cherry-embedded/HSLink-hardware/HSLinkIso_v1.2.2/HSLinkIso_v1.2.2.pdf

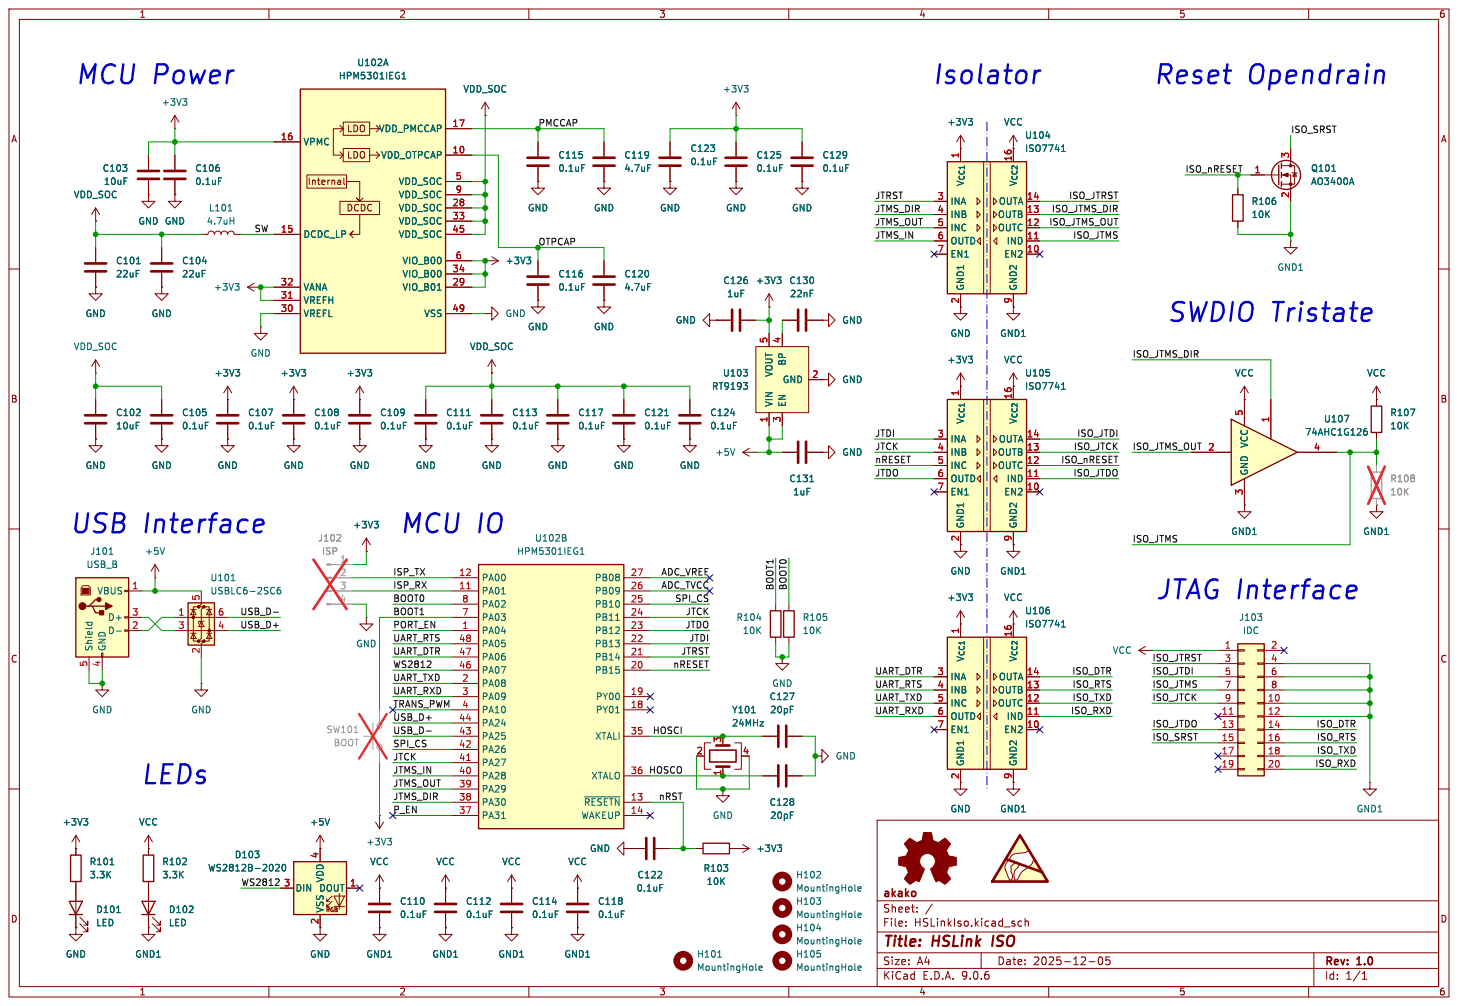
[picture p1: page 1]

File: HSLinkIso.kicad_sch Sheet: / akako

Id: 1/1 Title: HSLink ISO
