cherry-embedded/HSLink-hardware/HSLinkIso_v1.2.2/HSLinkIso.kicad_pcb

## KiCad design HSLinkIso_v1.2.2/HSLinkIso.kicad_pcb (2025-12-05)

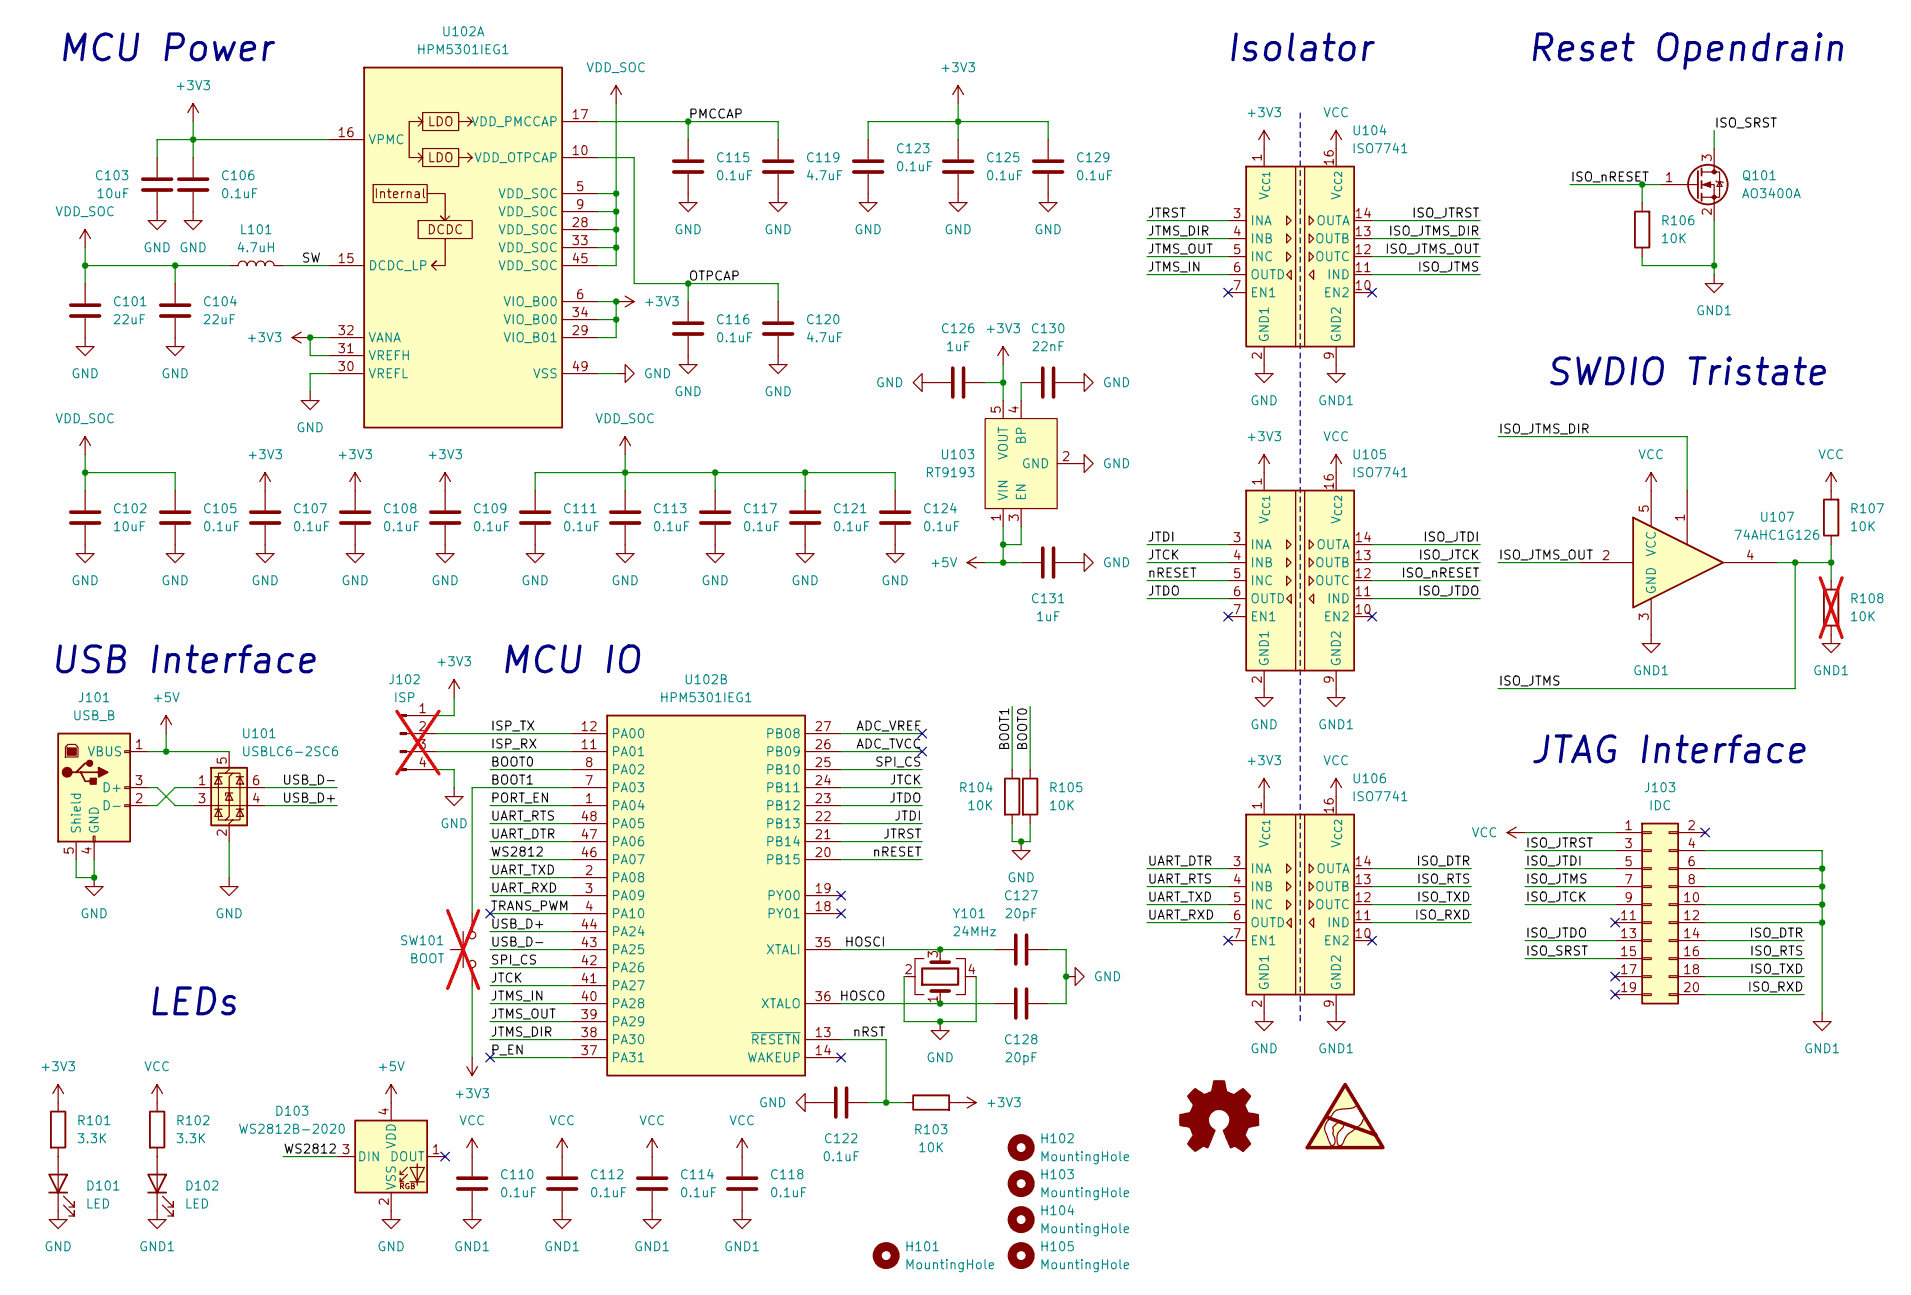
[picture p2: schematic HSLinkIso.kicad_sch, HSLink ISO]

Parts:
C101, C104: 22uF; C_0805_2012Metric
C102, C103: 10uF; C_0805_2012Metric
C105, C106, C107, C108, C109, C110, C111, C112, C113, C114, C115, C116, C117, C118, C121, C122, C123, C124, C125, C129: 0.1uF; C_0603_1608Metric
C119, C120: 4.7uF; C_0603_1608Metric
C126, C131: 1uF; C_0603_1608Metric
C127, C128: 20pF; C_0603_1608Metric
C130: 22nF; C_0603_1608Metric
D101, D102: LED; LED_0603_1608Metric
D103: WS2812B-2020; LED_WS2812B-2020_PLCC4_2.0x2.0mm
H101: MountingHole; MountingHole_3.2mm_M3
H102, H103, H104, H105: MountingHole; MountingHole_2.2mm_M2
J101: USB_B; USB_B_Lumberg_2411_02_Horizontal
J102: ISP; PinHeader_1x04_P2.54mm_Vertical; not fitted
J103: IDC; IDC-Header_2x10_P2.54mm_Horizontal
L101: 4.7uH; L_Sunlord_SWPA4020S
Q101: AO3400A; SOT-23
R101, R102: 3.3K; R_0603_1608Metric
R103, R104, R105, R106, R107: 10K; R_0603_1608Metric
R108: 10K; R_0603_1608Metric; not fitted
SW101: BOOT; PinHeader_1x02_P2.54mm_Vertical; not fitted
U101: USBLC6-2SC6; SOT-23-6
U102: HPM5301IEG1; QFN-48-1EP_6x6mm_P0.4mm_EP4.2x4.2mm
U103: RT9193; SOT-23-5
U104, U105, U106: ISO7741; QSOP-16_3.9x4.9mm_P0.635mm
U107: 74AHC1G126; SOT-23-5
Y101: 24MHz; Crystal_SMD_3225-4Pin_3.2x2.5mm

Connections:
+3V3: C103.1, C106.1, C107.1, C108.1, C109.1, C123.1, C125.1, C126.1, C129.1, J102.1, R101.1, R103.2, SW101.2, U102.6 (VIO_B00), U102.16 (VPMC), U102.29 (VIO_B01), U102.31 (VREFH), U102.32 (VANA), U102.34 (VIO_B00), U103.5 (VOUT), U104.1 (V_{CC1}), U105.1 (V_{CC1}), U106.1 (V_{CC1})
+5V: C131.1, D103.4 (VDD), J101.1 (VBUS), U101.5 (VBUS), U103.1 (VIN), U103.3 (EN)
/ADC_TVCC: U102.26 (PB09)
/ADC_VREF: U102.27 (PB08)
/BOOT0: R105.1, U102.8 (PA02)
/BOOT1: R104.1, SW101.1, U102.7 (PA03)
/HOSCI: C127.1, U102.35 (XTALI), Y101.3
/HOSCO: C128.1, U102.36 (XTALO), Y101.1
/ISO_DTR: J103.14, U106.14 (OUTA)
/ISO_JTCK: J103.9, U105.13 (OUTB)
/ISO_JTDI: J103.5, U105.14 (OUTA)
/ISO_JTDO: J103.13, U105.11 (IND)
/ISO_JTMS: J103.7, R107.1, R108.2, U104.11 (IND), U107.4
/ISO_JTMS_DIR: U104.13 (OUTB), U107.1
/ISO_JTMS_OUT: U104.12 (OUTC), U107.2
/ISO_JTRST: J103.3, U104.14 (OUTA)
/ISO_RTS: J103.16, U106.13 (OUTB)
/ISO_RXD: J103.20, U106.11 (IND)
/ISO_SRST: J103.15, Q101.3 (D)
/ISO_TXD: J103.18, U106.12 (OUTC)
/ISO_nRESET: Q101.1 (G), R106.2, U105.12 (OUTC)
/ISP_RX: J102.3, U102.11 (PA01)
/ISP_TX: J102.2, U102.12 (PA00)
/JTCK: U102.24 (PB11), U102.41 (PA27), U105.4 (INB)
/JTDI: U102.22 (PB13), U105.3 (INA)
/JTDO: U102.23 (PB12), U105.6 (OUTD)
/JTMS_DIR: U102.38 (PA30), U104.4 (INB)
/JTMS_IN: U102.40 (PA28), U104.6 (OUTD)
/JTMS_OUT: U102.39 (PA29), U104.5 (INC)
/JTRST: U102.21 (PB14), U104.3 (INA)
/OTPCAP: C116.1, C120.1, U102.10 (VDD_OTPCAP)
/PMCCAP: C115.1, C119.1, U102.17 (VDD_PMCCAP)
/PORT_EN: U102.1 (PA04)
/P_EN: U102.37 (PA31)
/SPI_CS: U102.25 (PB10), U102.42 (PA26)
/SW: L101.2, U102.15 (DCDC_LP)
/TRANS_PWM: U102.4 (PA10)
/UART_DTR: U102.47 (PA06), U106.3 (INA)
/UART_RTS: U102.48 (PA05), U106.4 (INB)
/UART_RXD: U102.3 (PA09), U106.6 (OUTD)
/UART_TXD: U102.2 (PA08), U106.5 (INC)
/USB_D+: U101.4 (I/O2), U102.44 (PA24)
/USB_D-: U101.6 (I/O1), U102.43 (PA25)
/WS2812: D103.3 (DIN), U102.46 (PA07)
/nRESET: U102.20 (PB15), U105.5 (INC)
/nRST: C122.1, R103.1, U102.13 (~RESETN)
GND: C101.2, C102.2, C103.2, C104.2, C105.2, C106.2, C107.2, C108.2, C109.2, C111.2, C113.2, C115.2, C116.2, C117.2, C119.2, C120.2, C121.2, C122.2, C123.2, C124.2, C125.2, C126.2, C127.2, C128.2, C129.2, C130.2, C131.2, D101.1 (K), D103.2 (VSS), J101.4 (GND), J101.5 (Shield), J102.4, R104.2, R105.2, U101.2 (GND), U102.30 (VREFL), U102.49 (VSS), U103.2 (GND), U104.2 (GND1), U104.8 (GND1), U105.2 (GND1), U105.8 (GND1), U106.2 (GND1), U106.8 (GND1), Y101.2, Y101.4
GND1: C110.2, C112.2, C114.2, C118.2, D102.1 (K), J103.4, J103.6, J103.8, J103.10, J103.12, Q101.2 (S), R106.1, R108.1, U104.9 (GND2), U104.15 (GND2), U105.9 (GND2), U105.15 (GND2), U106.9 (GND2), U106.15 (GND2), U107.3 (GND)
unnamed: D101.2 (A), R101.2
unnamed: D102.2 (A), R102.2
unnamed: J101.3 (D+), U101.3 (I/O2)
unnamed: J101.2 (D-), U101.1 (I/O1)
unnamed: C130.1, U103.4 (BP)
VCC: C110.1, C112.1, C114.1, C118.1, J103.1, R102.1, R107.2, U104.16 (V_{CC2}), U105.16 (V_{CC2}), U106.16 (V_{CC2}), U107.5 (VCC)
VDD_SOC: C101.1, C102.1, C104.1, C105.1, C111.1, C113.1, C117.1, C121.1, C124.1, L101.1, U102.5 (VDD_SOC), U102.9 (VDD_SOC), U102.28 (VDD_SOC), U102.33 (VDD_SOC), U102.45 (VDD_SOC)

Notes on the sheet:
JTAG Interface
Isolator
USB Interface
Reset Opendrain
MCU Power
MCU IO
SWDIO Tristate
LEDs

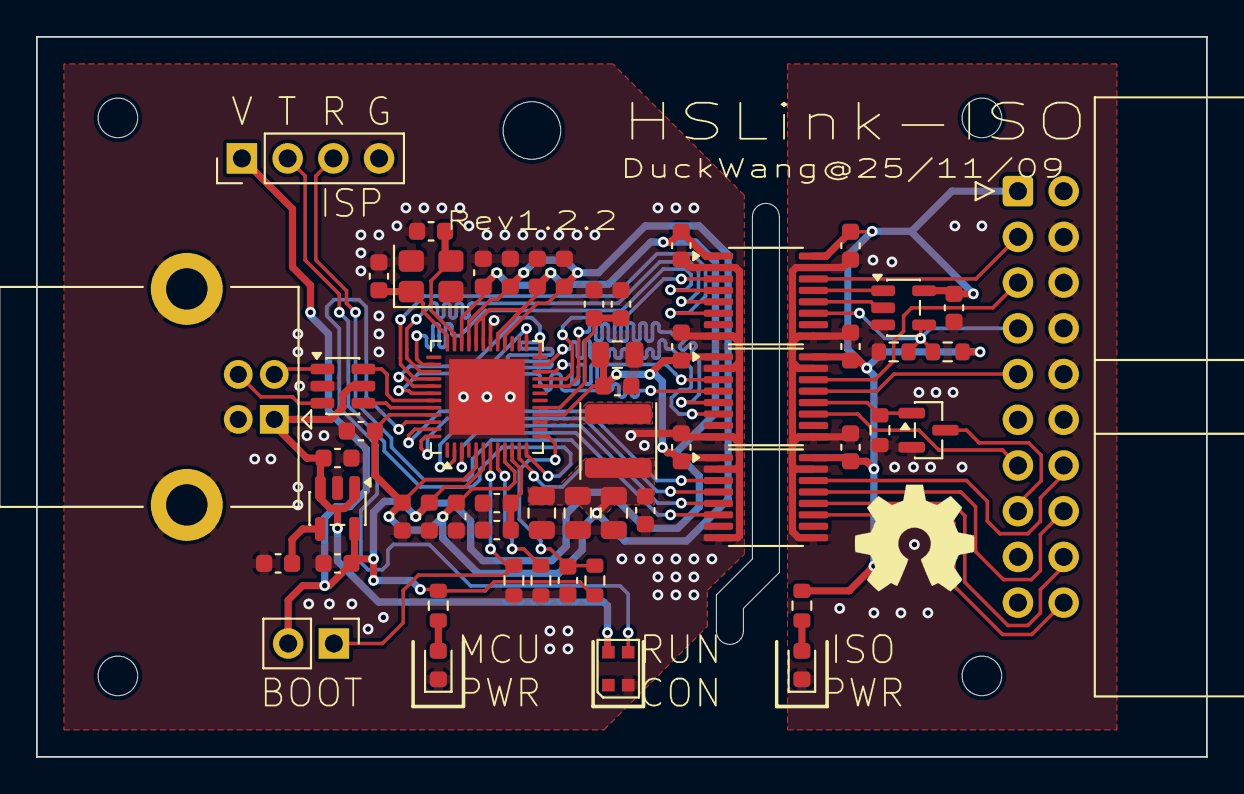
[picture p3: board HSLinkIso.kicad_pcb from above]

Board: 2 copper layers, 65.0 x 40.0 mm, 61 parts (0 on the bottom side), 50 nets.
